DorStern1990/AutoRecycle-Machine---IoT-Raspberry-Java/Project Diagram.pdf

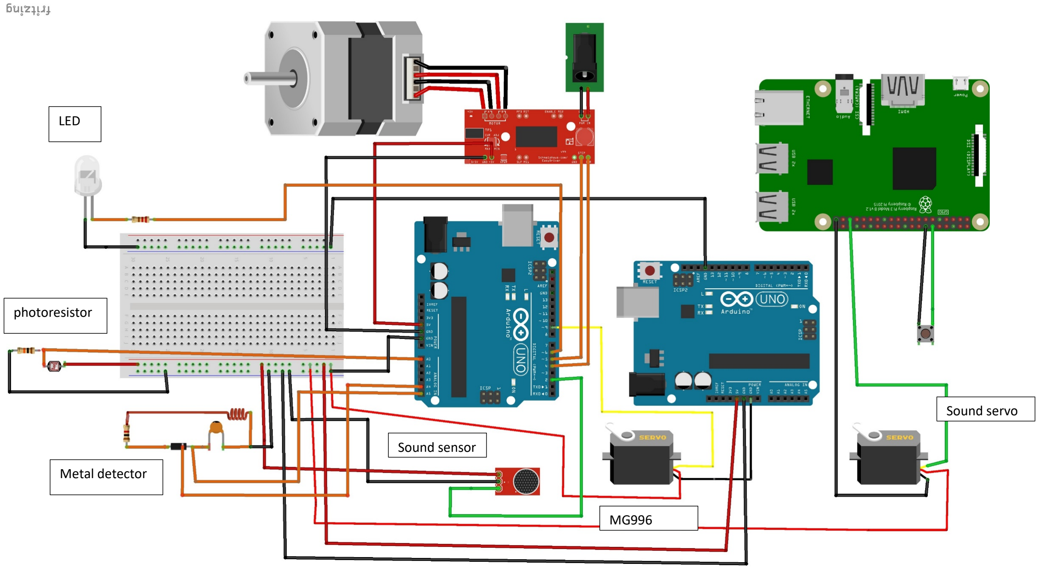
[picture p1: page 1]

LED

photoresistor

Metal detector

Sound sensor

Sound servo

MG996
