DorStern1990/AutoRecycle-Machine---IoT-Raspberry-Java/Project Report.pdf

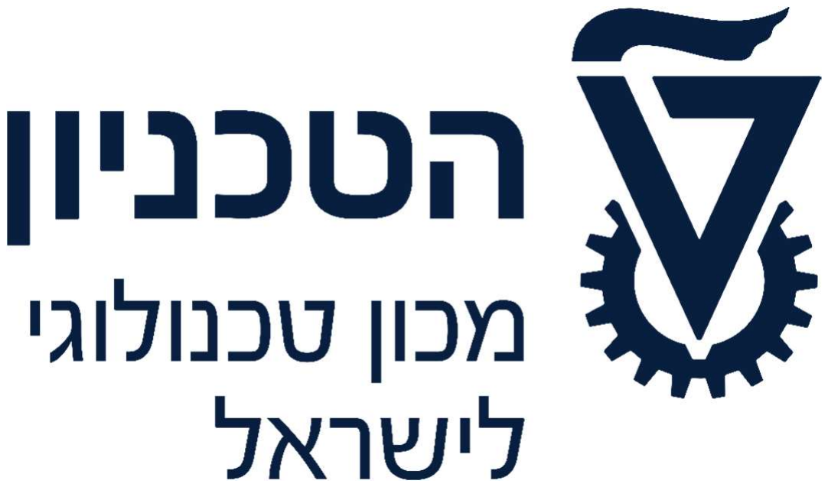
[picture p2: figure]

# Auto Recycle Machine

Itay Dabran | Dor Stern
Boris Ban Sosin | Yoav Malul
Lina Maudlej | Kfir Shalev
Gal Peretz

תמצית :
המסמך הבא מפרט את הרכיבים ממנו בנוי הפרויקט , את אופן העיצוב הכולל של המוצר וכן את החלק התכנותי של הפרויקט העוסק במכונת המחזור האוטומטי. מכונת מחזור אוטומטי שתמיין את מוצרי מחזור : זכוכית , פלסטיק , קרטון , מתכת וכו'. הסיווג של המוצרים נעשה על ידי תוכנה בענן של azure המשתמשת ב AI vision custom , ובמספר חיישנים הבודקים תכונות פיזיות נוספות שיפורטו במסמך. מטרת העל של הפרויקט: בנאדם המעוניין למיין את מוצרי האשפה למחזור יגיע אל המכונה יניח את הפריט במרכז הקופסא, הפריט יזוהה על ידי המערכת זיהוי תמונה וכן על ידי החיישנים ויושלך לפח המתאים.

תיאור :
מכונת המחזור האוטומטית בנויה מעץ. המכונה מורכבת מקופסת עץ שנעה על גבי מערכת מסילות שמתחתיה פזורים הפחים, מיקום הפחים נקבע באופן רנדומלי אך הוגדר בקוד בהתאם לתבנית ספציפית.
המוצרים הניתנים לזיהוי על ידי המכונה הם : זכוכית , פלסטיק , מתכת , וקרטון אך ניתן להתאים את המערכת לסוגי מוצרים נוספים , אך העניין דורש אימון נוסף למערכת זיהוי התמונה, וכן שינוי גודל המסילה.

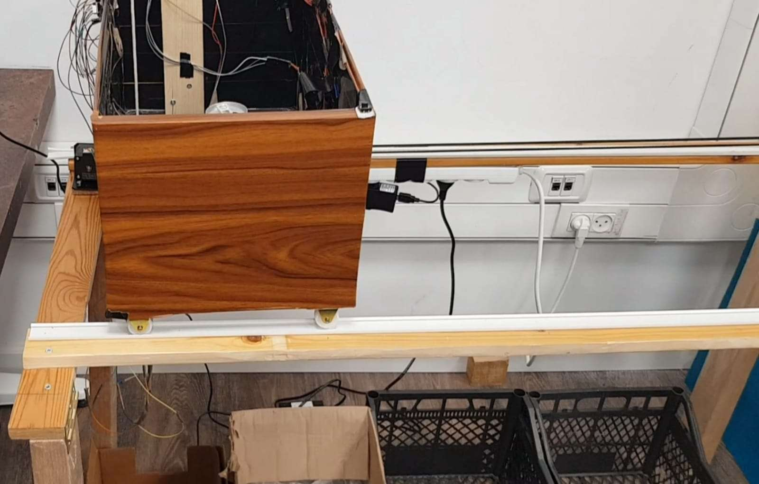
[picture p3: figure]

המערכת פותחה בעזרת מכשרי + B 3 Pi Raspberry וכן שני Uno Arduino , כאשר ברספברי הקוד נכתב בשפת פייתון ועל הארדואינו נכתב קוד בשפת ++C .

רפסברי פי הוא מכשיר ממשפחת מחשבי לוח יחיד , בעלי מיקרו מעבדים.(איור 1) ארדואינו הוא מיקרו-בקר בעל מעגל מודפס יחיד עם סביבת פיתוח משולבת אשר מטרתה ליצור סביבה נוחה וזולה לפיתוח פרויקטים המשלבים תוכנה עם רכיבי אלקטרוניקה.(איור 2) הפלטפורמה הפיזית של הארדואינו מבוסס על מעגלים המודפסים על הלוח אשר מקשרים בין המיקרו קונטרולרים לבין היציאות input/output, הארדואינו מכיל ווסת מתח וממשק USB המאפשר תקשורת עם המחשב המשמש לתכנות. המתח עבור הארדואינו יכול להגיע דרך כבל הUSB המחובר למחשב וכן דרך מתח DC על ידי ספק כוח של 9 וולט.

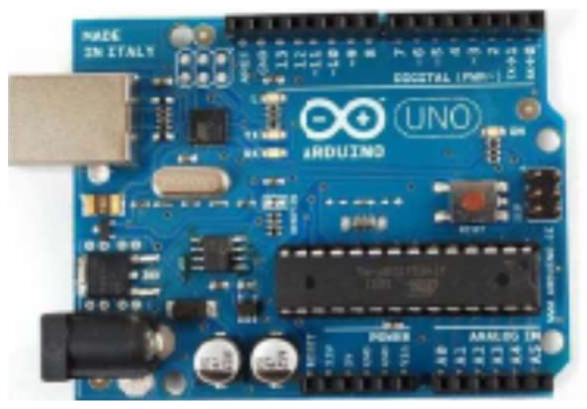
[picture p4: figure]
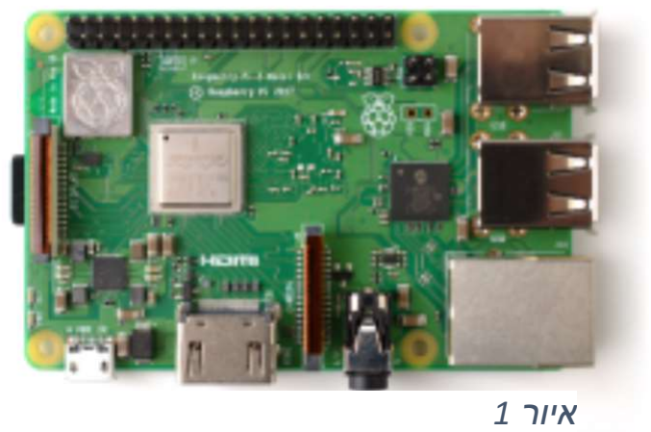
[picture p5: figure]
איור 1

איור 2

חומרים ורכיבים נוספים שבהם היה שימוש:
- 17 Nema – מנוע צעד שנשלט על ידי דרייבר 4988A היושב על controller 4-434HW.

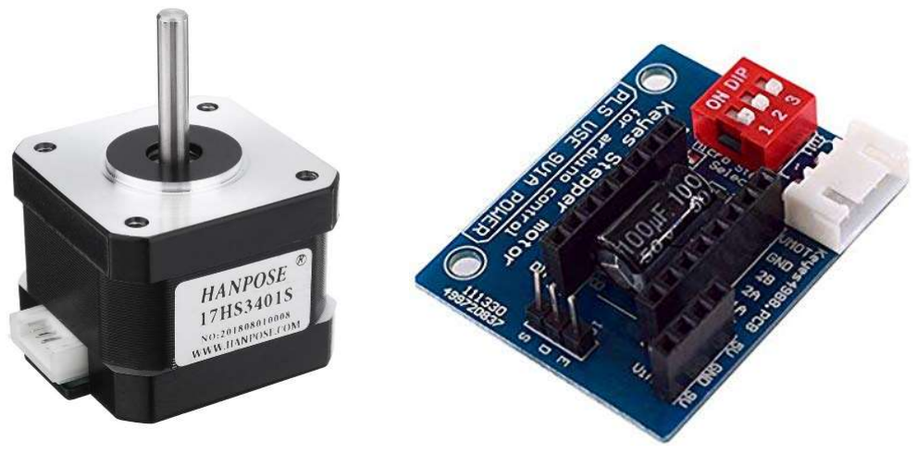
[picture p6: figure]
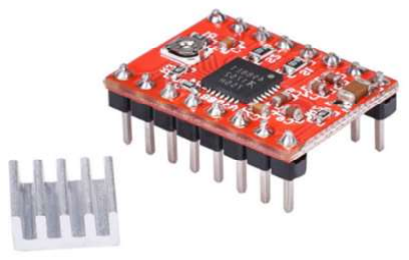
[picture p7: figure]

מנוע צעד הוא סוג של מנוע סינכרוני אשר מחלק את הצעדים שלו לרגעים. ישנם שני סוגי מנועי nema אנו נשתמש בפרויקט בסוג הדו קוטבי.

על מנת להניע את מנוע הצעד דרך הארדואינו , נדרשת תוספת הדרייבר והקונטרולר המאפשרים לווסתם את זרימת הזרם הדרושה להפעיל את המנוע עצמו . רכיב זה הוא ה 4988A.

מוטור | סרבו | – MG 996R

סרבו מוטורים הם סוג מסוים של מנוע בדרך כלל בעלי עוצמה קטנה. הדגם בו נשתמש הוא R996MG בעל סיבוב רציף.

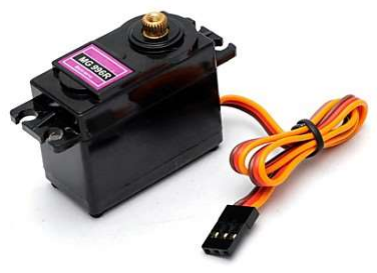
[picture p8: figure]

Raspberry Pi camera |
מצלמת 5 מגה פיקסל שמתחברת לרספברי על ידי כבל ריבון

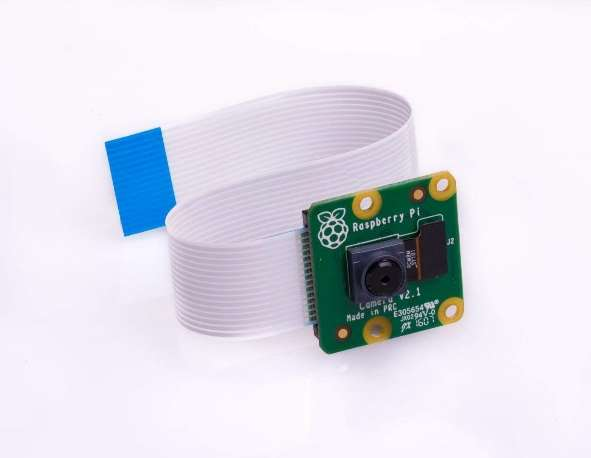
[picture p9: figure]

Breadboard
לוח בעל תשתית למעגלים חשמליים

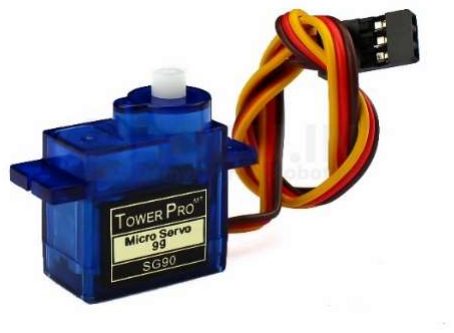
[picture p10: figure]

– Micro Servo SG90

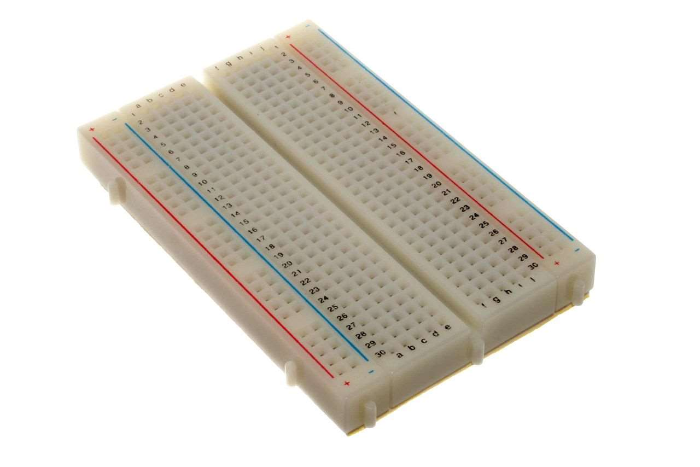
[picture p11: figure]

סרבו מוטור קטן בעל יכולת תנועה של 180 מעלות.

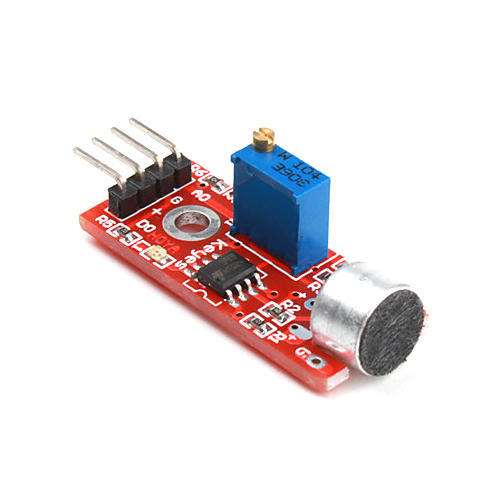
[picture p12: figure]

Uxcell sound sensor
חיישן קול בעל רגישות גבוהה על ידי מיקרופון.

Photoresistor and led 20mm

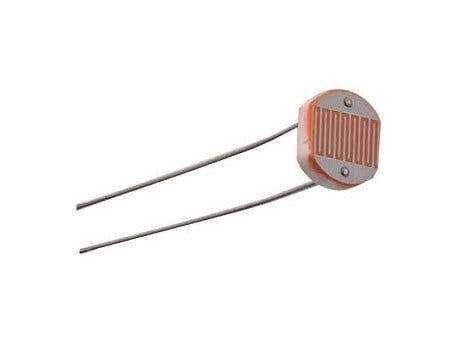
[picture p13: figure]

- סליל מחוט נחושת
- כפתור

רכיבים של המבנה :
לוחות עץ
מסמרים וברגים
גומי הנעה

### 4 גלגלים של ספה

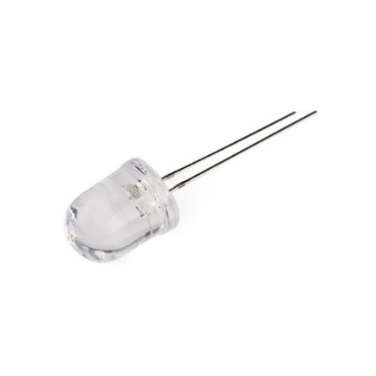
[picture p14: figure]

## תהליך העבודה לבניית המערכת:

התהליך מחולק לשני חלקים , החלק של תכנון המבנה הפיזי והפעלתו והחלק התכנותי. נתחיל מהחלק הפיזי של חומרת המערכת. ראשית השתמשנו ב4 חתיכות עץ לטובת יצירת הקופסא המרכזית ועטפנו אותו בנייר עטיפה. בתוך הקופסא מונח הפריט שאמור להיות מזוהה על ידי לקיחת תמונה ממצלמת הcamera PI) פריט 7) את המצלמה מיקמנו בזווית אופטימלית על חתיכת עץ המוצמדת לדופן הקופסא לטובת זיהוי כל הפריטים בצורה המיטבית ביותר ואת הזווית המדויקת השגנו על ידי זווית מפלסטיק. על אותה חתיכת עץ גם יושבים הרספברי (פריט 6) וכן מוט עץ נוסף(פריט 8) שבקצהו חוט שמאפשר את הפתיחה והסגירה של דלת הקופסה. בתחתית הקופסה ישנה דלת נפתחת שדרכה המוצר נופל את פח המחזור. לאחר שסיימנו לבנות ולתכנן את הקופסה הראשית בנינו את המסילה והתקנו את הגלגלים (פריט 9) עבור הקופסא בצורה שיאפשרו תנועה על גבי המסילה. הקופסא זזה על ידי מנוע הצעד שמחובר לרצועת הגומי (פריט 10), הרצועה הזאת מחוברת בנוסף גם לקופסה ועל ידי כך המנוע מאפשרת את תנועתה על גבי המסילה. לאחר שסיימנו את הבנייה הפיזית של המערכת, החלנו בבדיקת הניסויים עבור החיישנים ומיקומם. חיישן גילוי המתכות המורכב מסליל של חוט נחושת מוקם במרכז הדלת הנפתחת ויוצרת מעיין תחום שבו צריך לשים את הפריטים.
חיישן הקול – מוצב בצד הקופסה ובצידה האנכי מוצב הסרבו הקטן שתפקידו להכות על מוט ברזל על הפריט בכדי לספק אינדקציה לחיישן הקול עבור זכוכית או פלסטיק. חיישן מדידת חדירות האור – מורכב מחיישן הפוטורסיסטור וכן נורת הלד שמורכבים בדפנות הקופסה. ולבסוף הוספנו את הכפתור שתפקידו לאותת למערכת כי הוכנס פריט חדש.

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
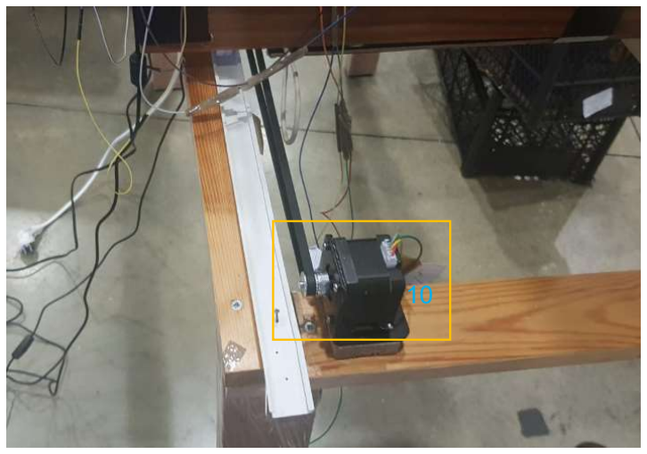
[picture p15: figure]
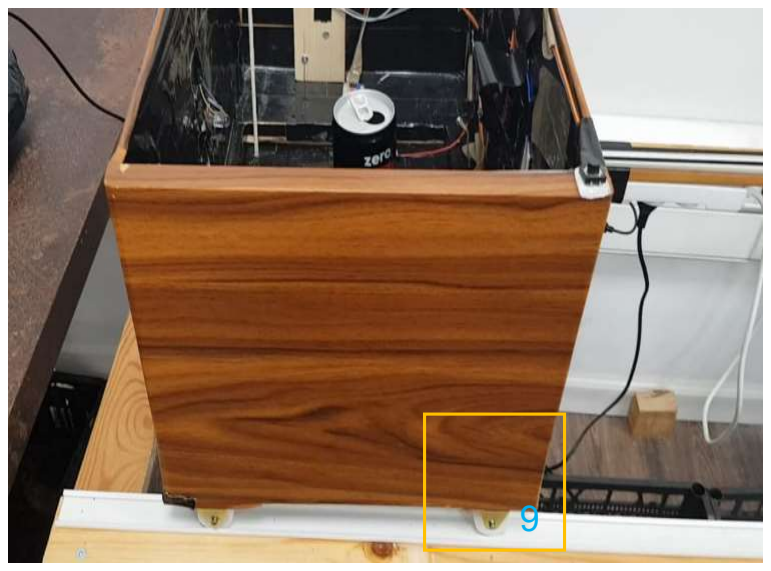
[picture p16: figure]

לאחר שסיימנו את כל הבנייה הפיזית של המערכת חיברנו את המעגלים החשמליים להפעלת כל החיישנים והמנועים באופן המתואר בשרטוט בעמוד המצורף

החלק התכנותי :
מימוש וניהול החיישנים והמנועים על ידי התוכנה בוצע על ידי קוד ברספברי וכן קוד על הארדואינו. חלוקת האחריות ביניהם מוגדרת באופן הבא: ארדואינו -
- מנוע צעד – אחראי על תזוזת הקופסה
- גלאי המתכות – כל המעגל החשמלי שעליו מבוסס גלאי המתכות מנוהל על ידי הארדואינו ששולח פולסים חשמליים למעגל ומודד את הזמן שלוקח לקבל להיטען ולפרוק.
- גלאי קול
- פוטורסיסטור והלד – הפעולה של הדלקת הלד ומדידת עוצמת האור העובר
- הסרבו שאחראי על סגירת הדלת. רספברי –
- כפתור – שתפקידו לסמן למערכת שפריט חדש הוכנס
- צילום התמונה – הרספברי לוקח תמונה באמצעות הcamera pi ושולח אותה לענן שבתורו מחזיר את הסיווג המתאים.
החבילות הנדרשות להתקנה על הרפסברי הן : RPI.GPIO
Picamera
Pyserial
Camera
Azure-cognitiveservices-vision-customvision Python-firebase
והקוד שביצע הרספברי הוא :

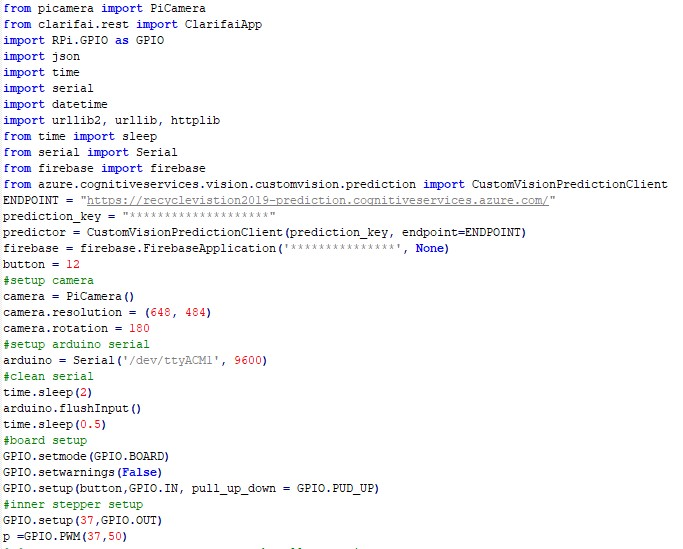
[picture p17: figure]
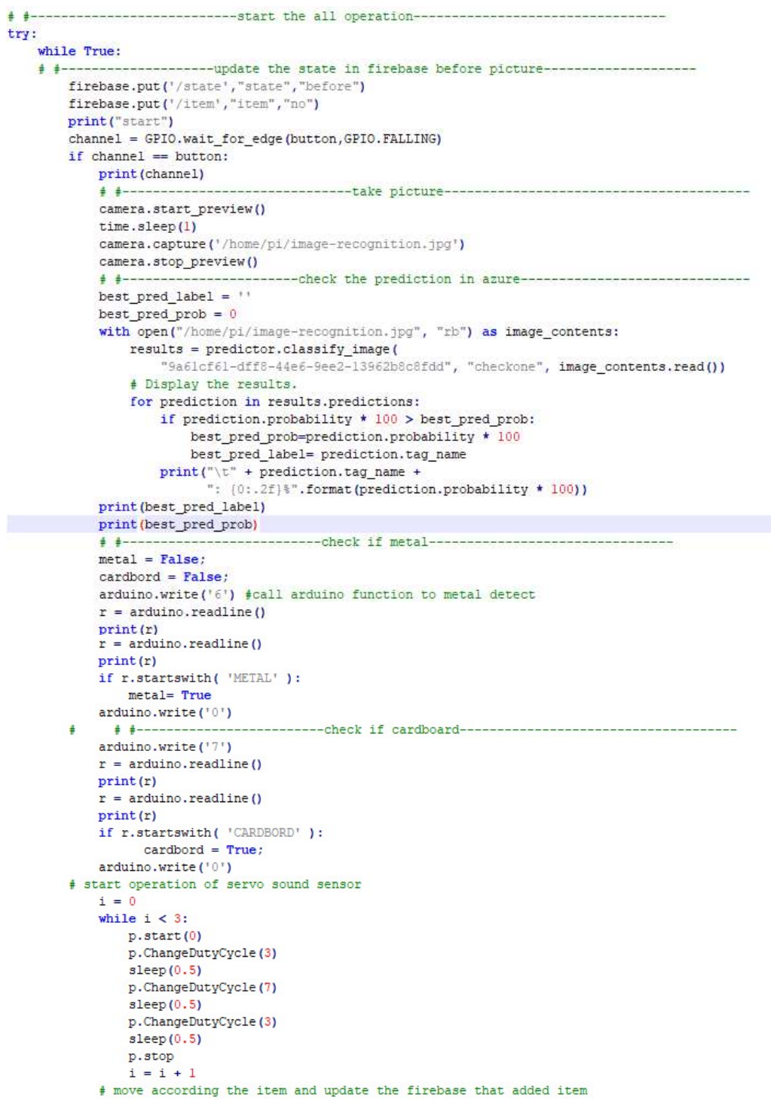
[picture p18: page 9]
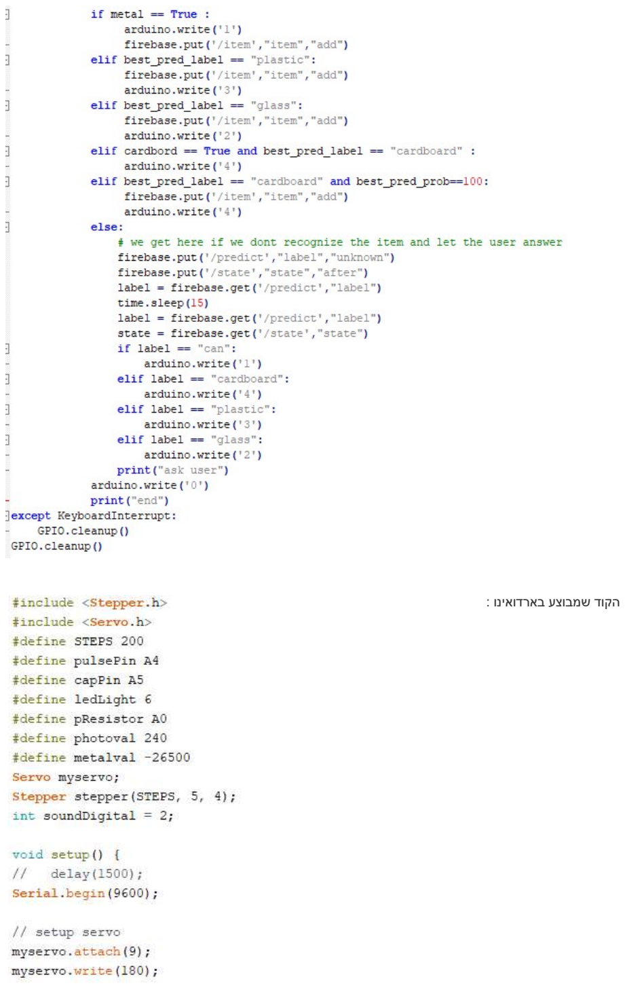
[picture p19: page 10]

הקוד שמבוצע בארדואינו :

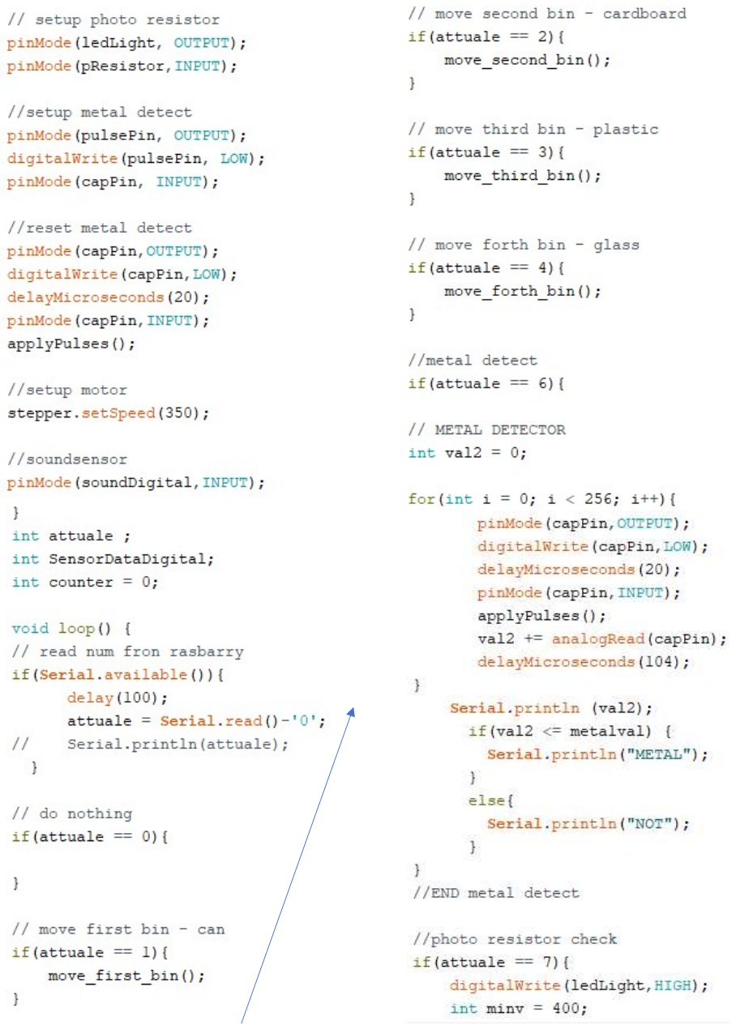
[picture p20: page 11]
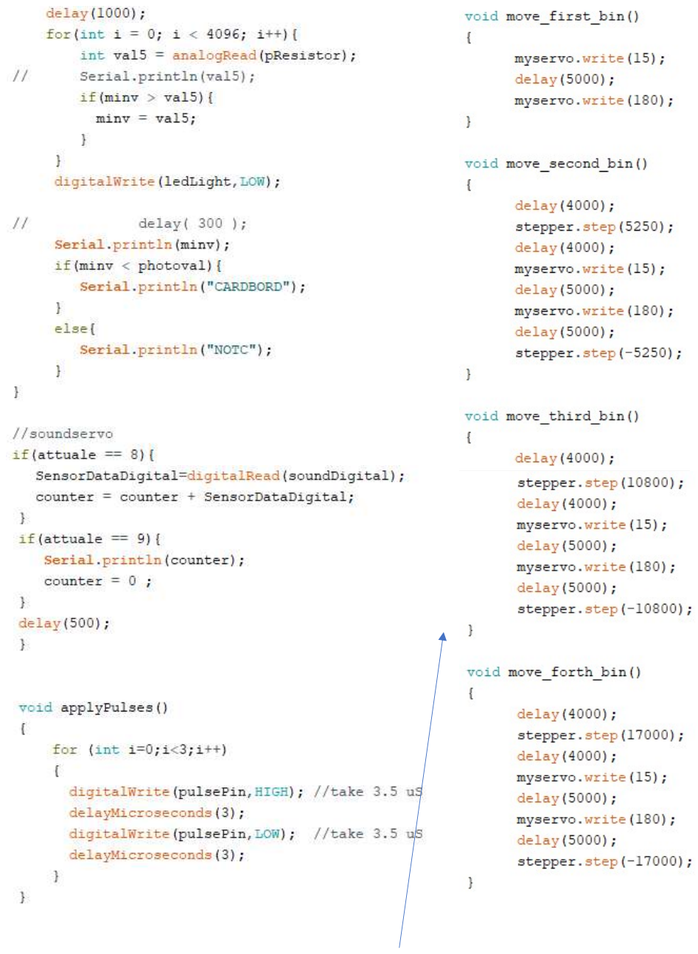
[picture p21: page 12]

## אפליקציה :

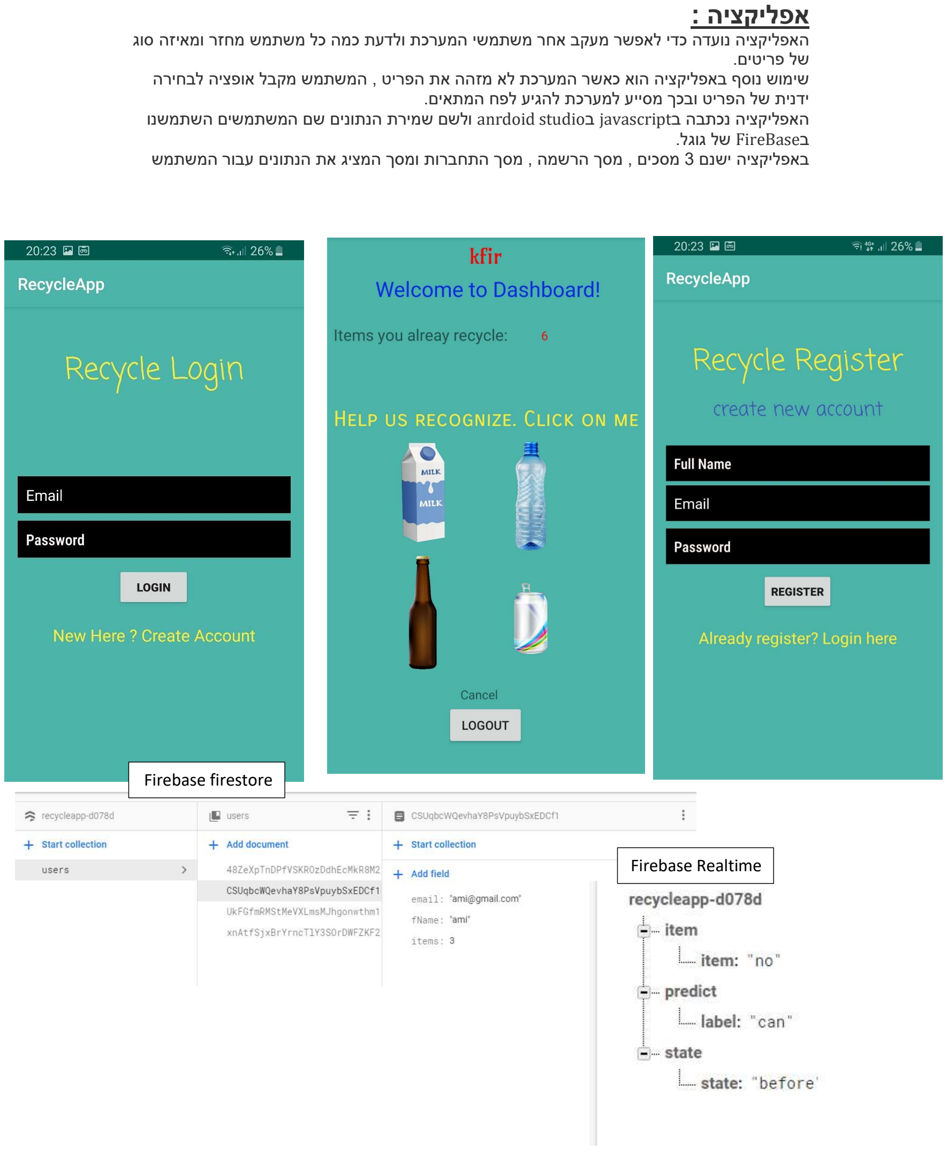
[picture p22: page 13]

האפליקציה נועדה כדי לאפשר מעקב אחר משתמשי המערכת ולדעת כמה כל משתמש מחזר ומאיזה סוג של פריטים.
שימוש נוסף באפליקציה הוא כאשר המערכת לא מזהה את הפריט , המשתמש מקבל אופציה לבחירה ידנית של הפריט ובכך מסייע למערכת להגיע לפח המתאים. האפליקציה נכתבה בjavascript בstudio anrdoid ולשם שמירת הנתונים שם המשתמשים השתמשנו בFireBase של גוגל.
באפליקציה ישנם 3 מסכים , מסך הרשמה , מסך התחברות ומסך המציג את הנתונים עבור המשתמש

Firebase firestore

Firebase Realtime

## סדר הפעולות בהפעלת המערכת :

.1 המשתמש מניס את הפריט במרכז הקופסה ולוחץ על הכפתור .2 המצלמה לוקחת תמונה והתמונה נשלחת לענן .3 הענן מחזיר את הזיהוי המשוער של הפריט .4 הגלאי מתכות מבצע את פעולתו ומזהה אם הפריט מתכתי .5 האור נדלק ומודד את כמות האור המתקבלת בחיישן .6 הסרבו הקטן מקיש על הפריט כדי לזהות את הקול .7 התוכנית מחליטה באיזה פריט מדובר .8 אם התוכנית לא הצליחה להסיק את סוג הפריט מופיע בקשה באפליקציה לזיהוי ידני .9 המנוע צעד מתחיל לפעול ומזיז את הקופסה למיקום הנכון .10 הסרבו מוטור מופעל וגורם לפתיחת הדלת .11 הסרבו מוטור מופעל וסוגר את הדלת .12 מנוע הצעד מחזיר את הקופסה למיקום ההתחלתי

## מסקנות והצעות לשיפור :

האב טיפוס הנוכחי בוצע על ידי חומרים אלמנטריים וחתיכות עץ שנמצאו , אבל הבנייה יכולה להתבצע על ידי רכיבים איכותיים יותר ובהרכה איכותית יותר, ואף לעצב את המערכת כך שיום אחד יוכלו לשים אותה במקומות פרטיים וציבוריים כמו פח רגיל לכל דבר. כדי לשפר את המבנה יש צורך להשתמש במסילות מותאמות יותר שבהם הקופסא תזוז ללא הפרעה. הצעות נוספות לשיפור :
.1 ניתן להוסיף למערכת מתקן כלשהו שיבצע דחיסה לאשפה לפני זריקתה לפחים, כדי לחסוך מקום. .2 חיישני משקל שימוקמו בתחתית הפחים ויהיו מחוברים לצד כלשהי שבו יהיה חיווי על מצבם מבחינת כמות ותפוסה
.3 הוספת חיישני NFC אשר יסמנו לקופסה מתי היא מעל הפח המתאים וכך לאפשר למערכת להיות דינמית מבחינת מיקום הפחים ולא יהיה צורך להגדיר מראש את מספר הצעדים של המנוע. בעיות שקיימות במערכת כרגע : .1 תנועה – כאשר מזיזים את הקופסה לתחנה האחרונה כלומר לפח האחרון, התזוזה בחלק האחרון של המסילה לא מבוצעת בצורה חלקה כפי שקורה בשאר המסילה .2 חיישן קול – קושי בלמדוד באופן מספק את הרעש שמגיע מהנקישה על הזכוכית ולהבדילו מהרעש שמגיע מנקישה על פלסטיק (ככל הנראה בגלל רעש חיצוני וכן רעש המנוע) .3 מבנה – המבנה אינו חזק מספיק .4 זיהוי התמונה בענן – המאגר שלנו לא גדול מספיק בשביל למקסם את יכולות המערכת ולכן יש צורך באגירת מספר גדול יותר של תמונות.
